PHSecchi/robo_sumo/Esquema Elétrico/ROBO SUMO R1 - 3D Visualization.pdf

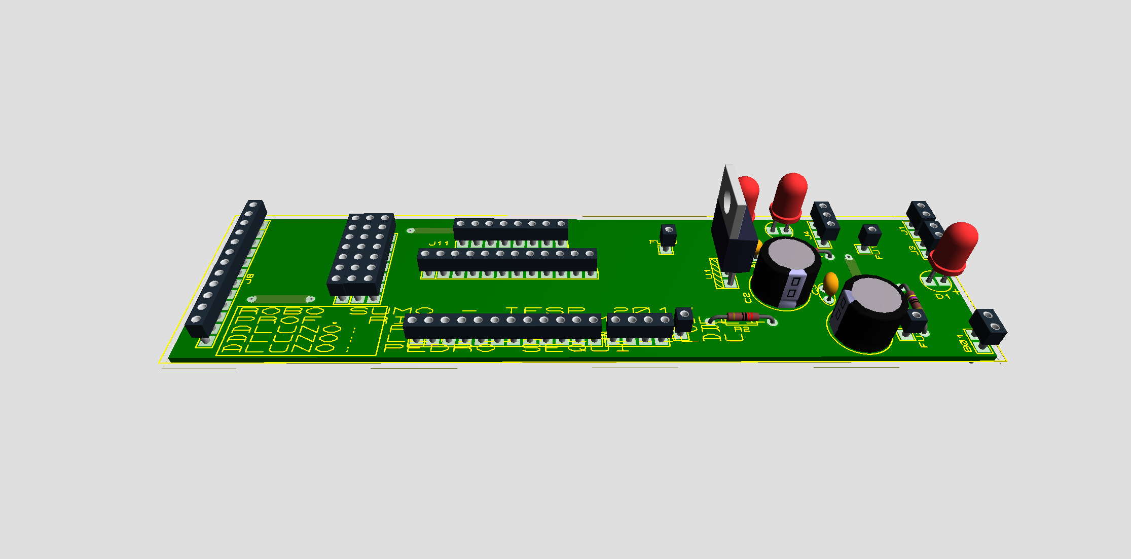
[picture p1: figure]
