PHSecchi/robo_sumo/Desenhos 3D/CONJ. CUBO RODA.pdf

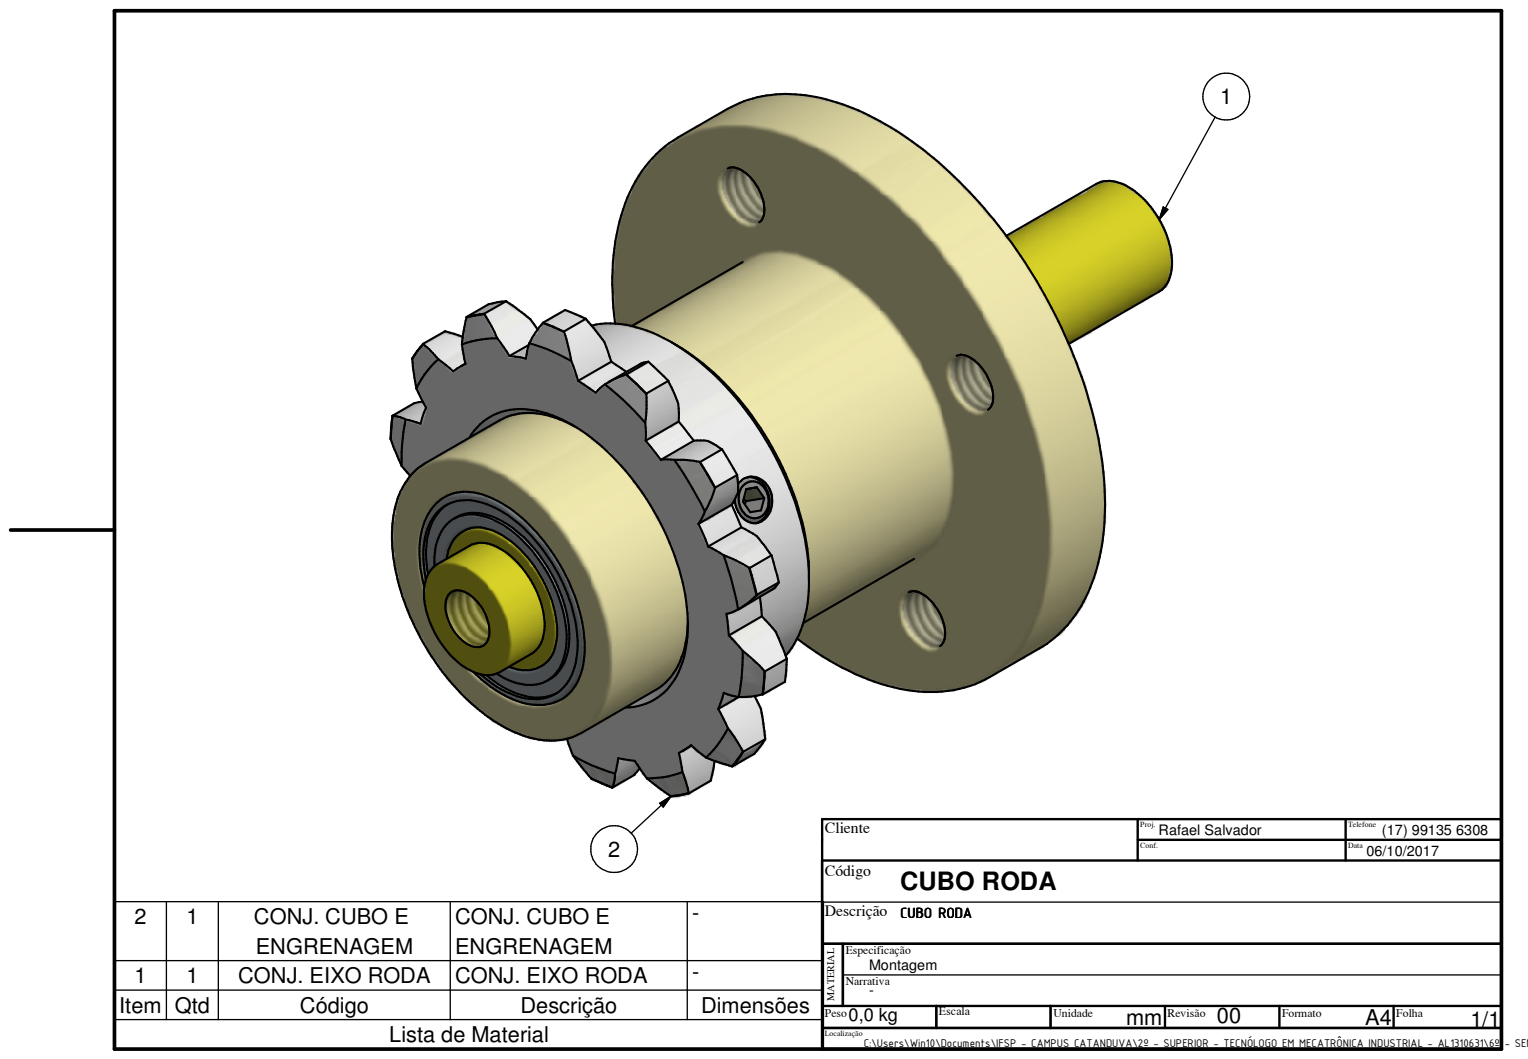
[picture p2: page 1]
Unidade; Código; Narrativa; CUBO RODA; Montagem - Localização; C:\Users\Win10\Documents\IFSP - CAMPUS CATANDUVA\2º - SUPERIOR - TECNÓLOGO EM MECATRÔNICA INDUSTRIAL - AL1310631\6º; - SEM; Peso0,0 kg; Formato; Folha; 1/1 Escala; Revisão 00; CONJ. EIXO RODA; - Lista de Material Item; Qtd; Descrição; Dimensões

Cliente | Proj. Rafael Salvador | Telefone (17) 99135 6308

Conf. | Data 06/10/2017

1 | CONJ. CUBO E | - ENGRENAGEM CONJ. CUBO E ENGRENAGEM 2 | Descrição CUBORODA

Especificação
