PHSecchi/robo_sumo/Desenhos 3D/CONJ. LATERAL ESQUERDO.pdf

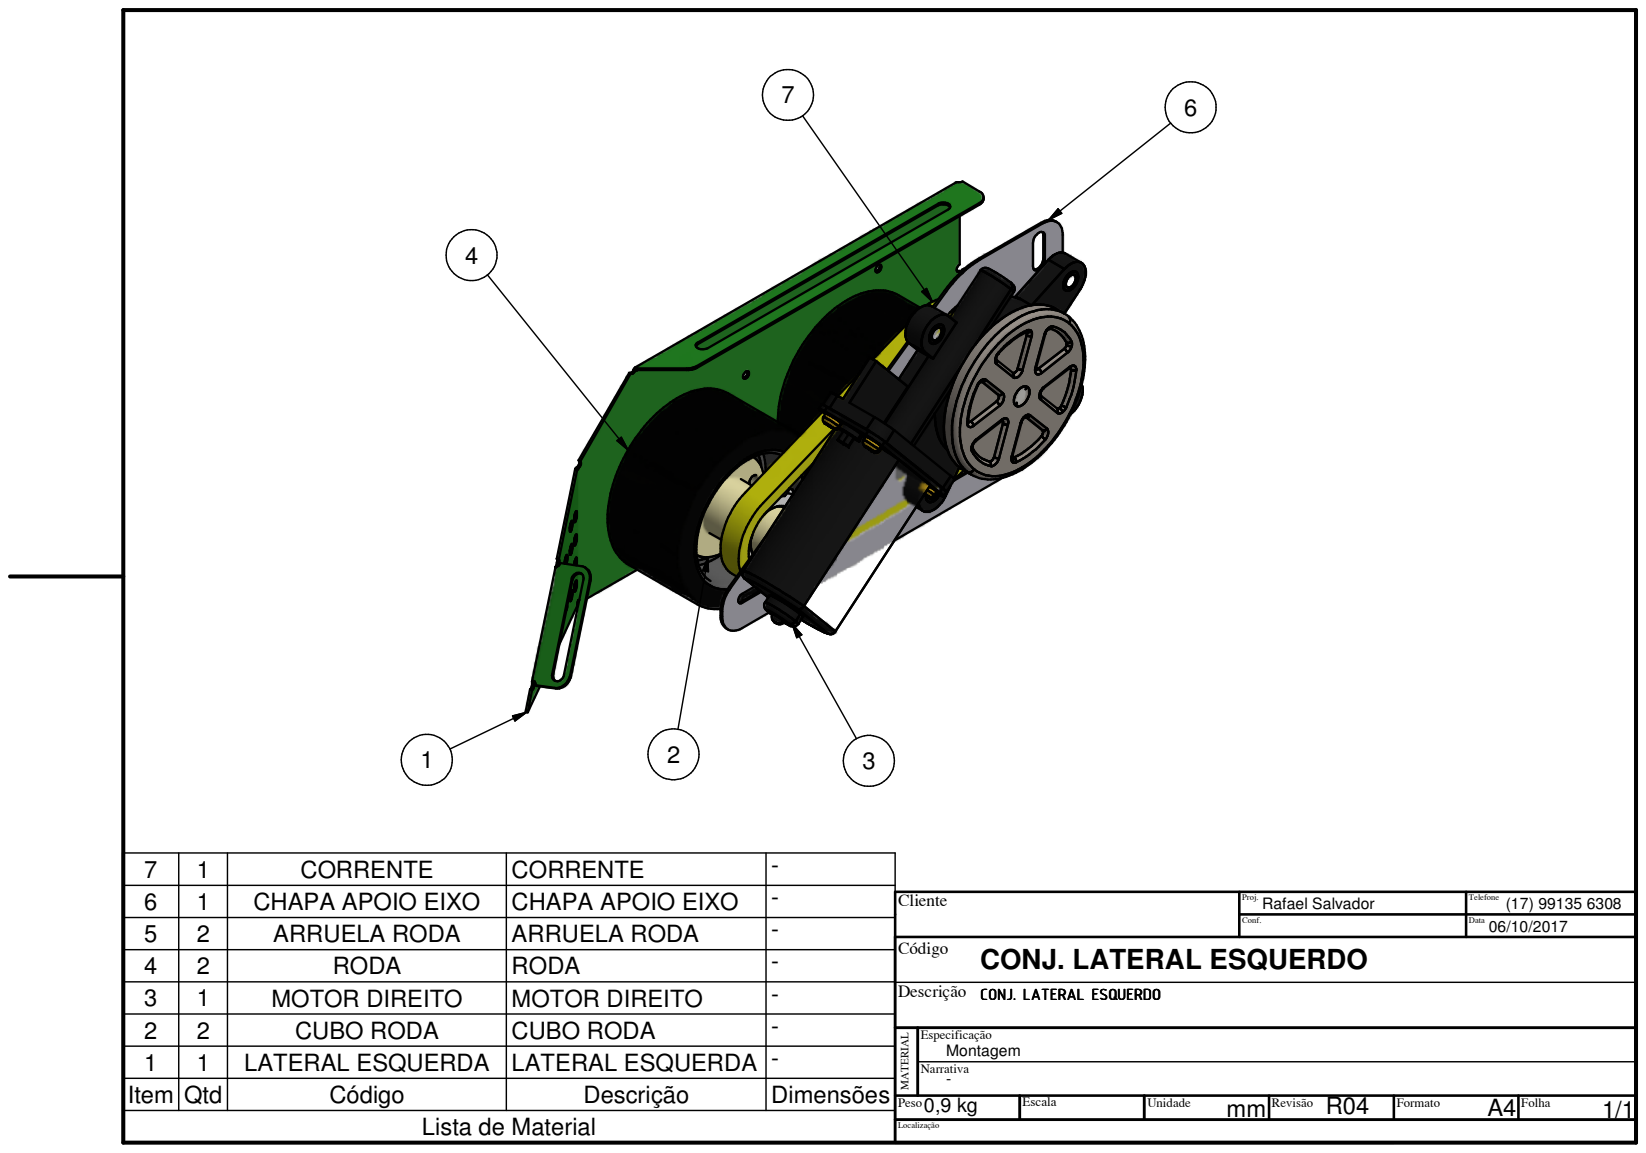
[picture p3: page 1]
Unidade; Código; Narrativa; Montagem - Localização; Peso0,9 kg; Formato; Folha; 1/1 Escala; Revisão R04; CORRENTE; CHAPA APOIO EIXO; ARRUELA RODA; RODA; MOTOR DIREITO; CUBO RODA; LATERAL ESQUERDA; - Lista de Material Item; Qtd; Descrição; Dimensões

Cliente | Proj. Rafael Salvador | Telefone (17) 99135 6308

Conf. | Data 06/10/2017

CONJ. LATERAL ESQUERDO

Descrição CONJ.LATERALESQUERDO

Especificação
