PHSecchi/robo_sumo/Desenhos 3D/ROBO SUMO.pdf

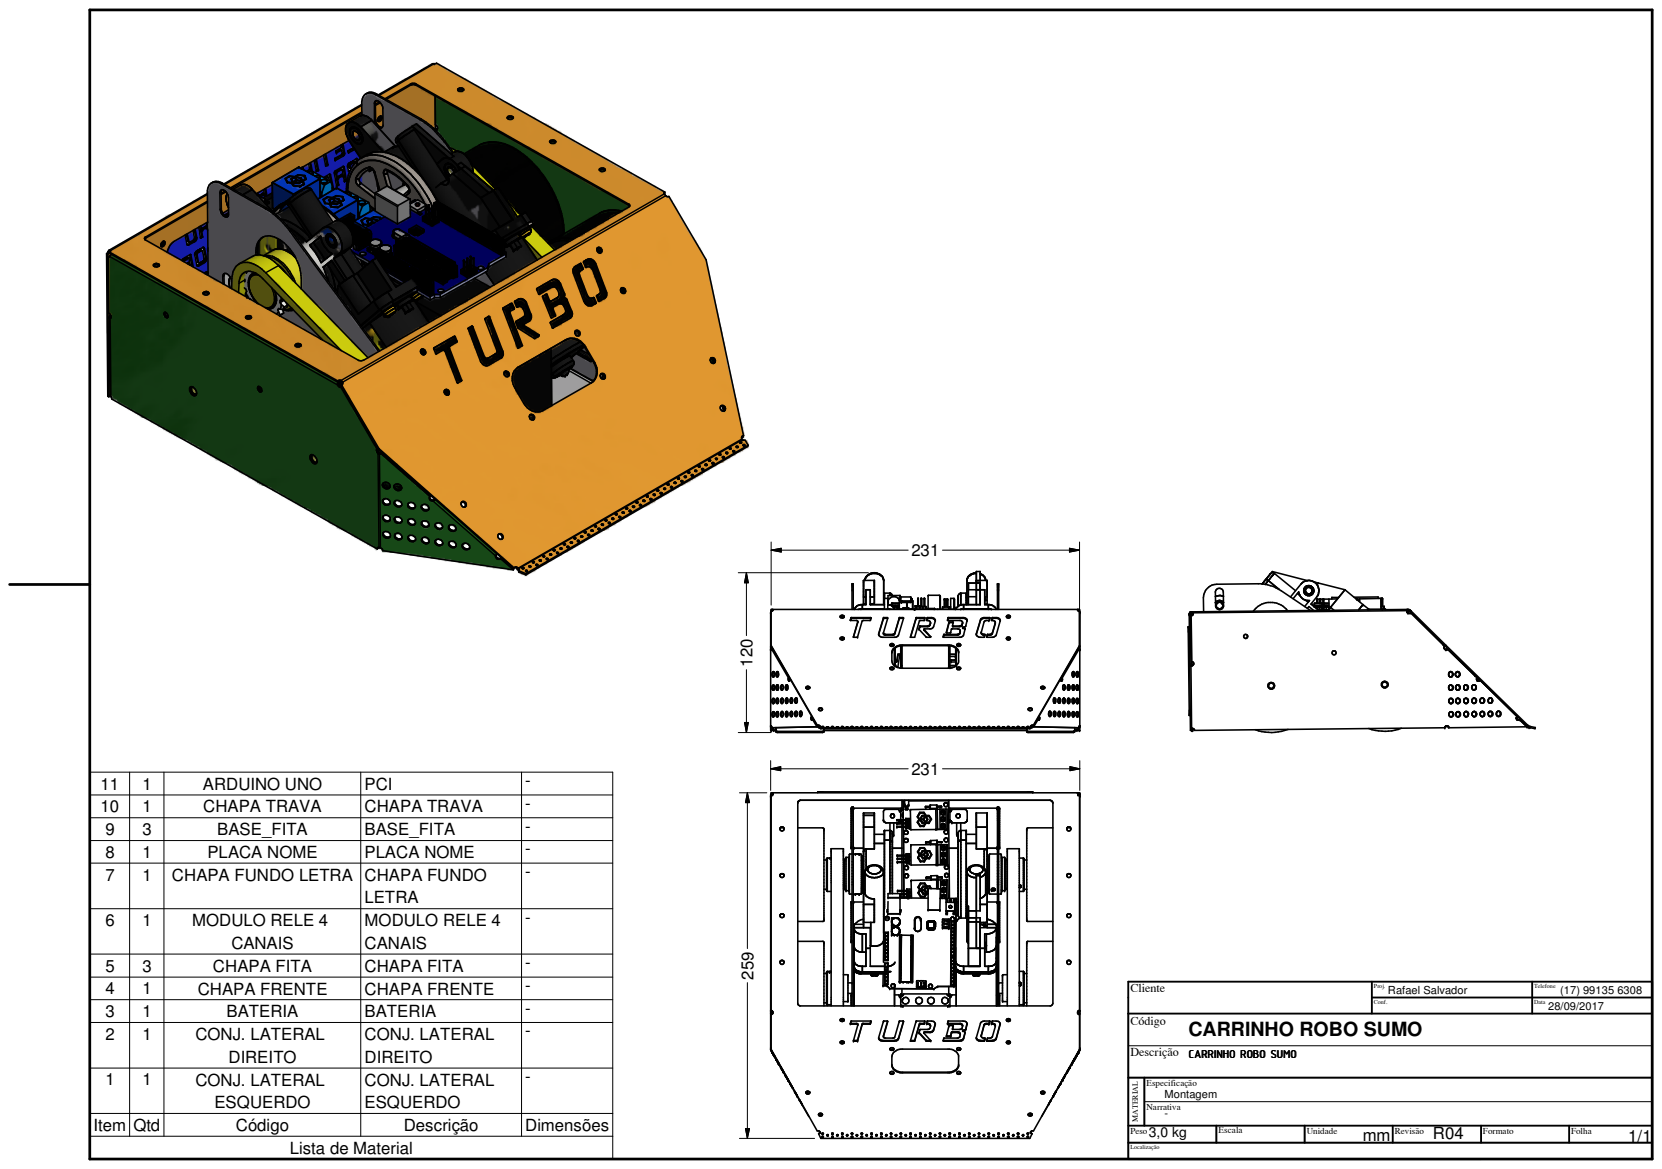
[picture p4: page 1]
Proj.; Conf.; Telefone; Unidade; MATERIAL; Código; Descrição; Especificação; Narrativa; CARRINHOROBOSUMO; Montagem; - Localização; Rafael Salvador; Peso3,0 kg; Formato; Folha; 1/1 Escala; Data 28/09/2017; Revisão R04; Cliente; ARDUINO UNO; PCI; CHAPA TRAVA; BASE_FITA; PLACA NOME; - CHAPA FUNDO; - LETRA; CHAPA FUNDO LETRA; MODULO RELE 4; CHAPA FITA; CHAPA FRENTE; BATERIA; - CONJ. LATERAL; CONJ. LATERAL; Item Qtd; Dimensões

- CANAIS MODULO RELE 4 CANAIS

CARRINHO ROBO SUMO

- DIREITO CONJ. LATERAL DIREITO

- ESQUERDO CONJ. LATERAL ESQUERDO

Lista de Material
