PHSecchi/robo_sumo/Desenhos 3D/CUBO RODA.pdf

n40

5

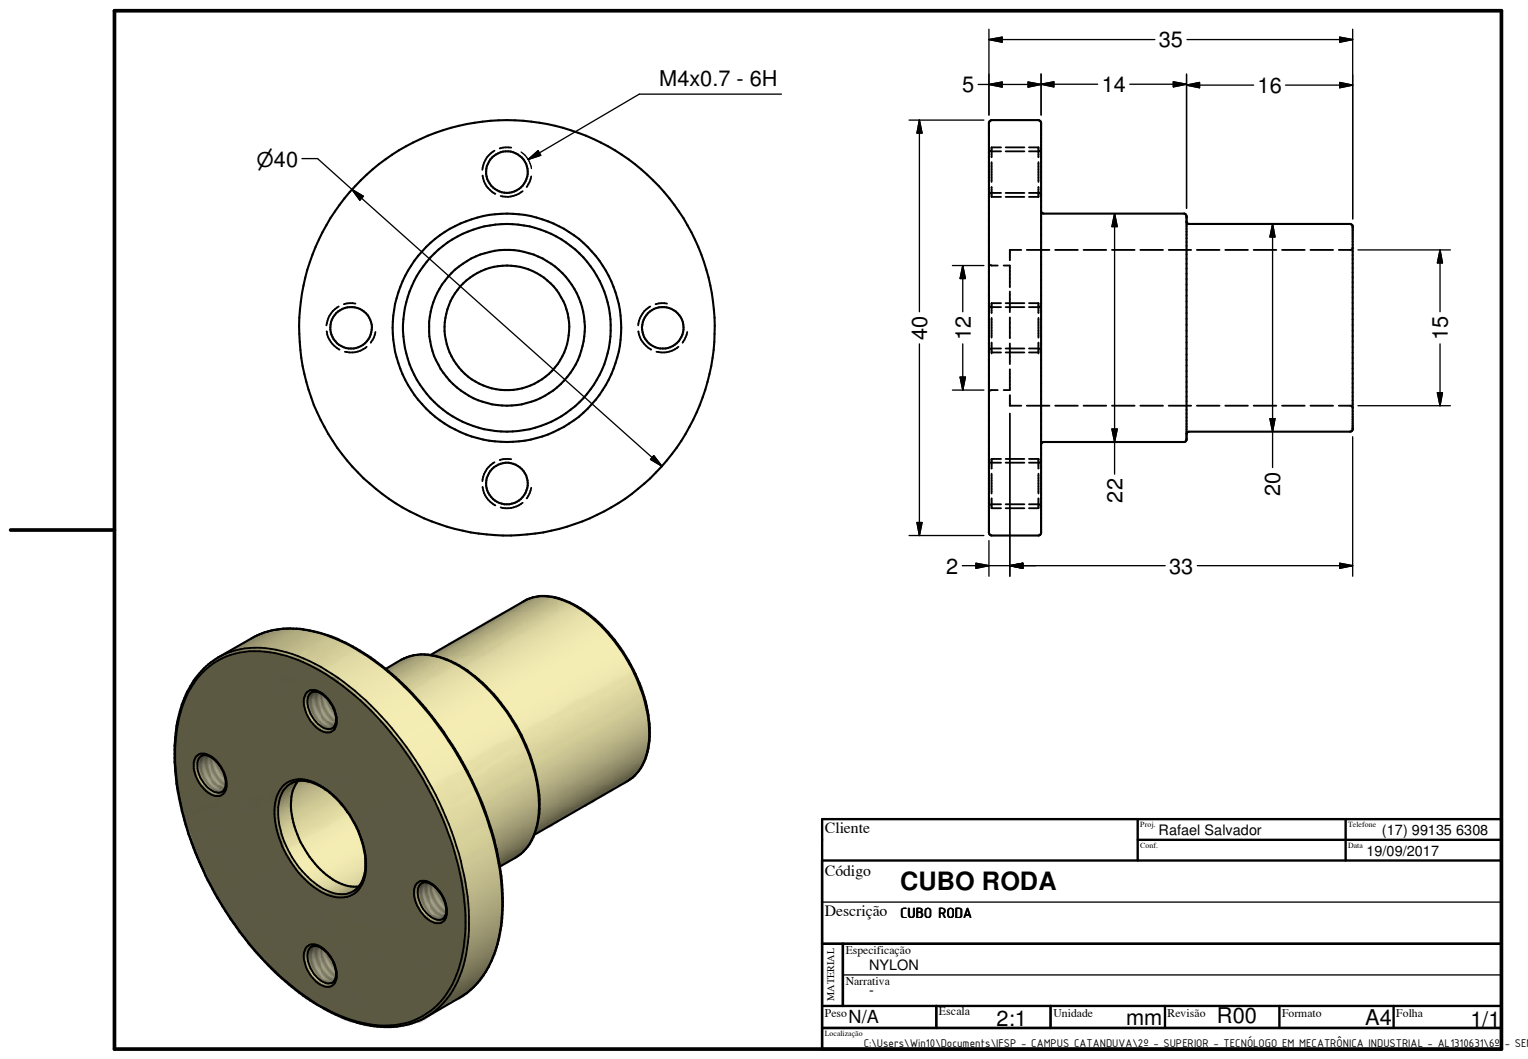
[picture p5: page 1]
Unidade; Código; Descrição; Especificação; Narrativa; CUBO RODA; CUBORODA; NYLON - Localização; C:\Users\Win10\Documents\IFSP - CAMPUS CATANDUVA\2º - SUPERIOR - TECNÓLOGO EM MECATRÔNICA INDUSTRIAL - AL1310631\6º; - SEM; PesoN/A; Formato; Folha; 1/1 Escala; Revisão R00

Cliente | Proj. Rafael Salvador | Telefone (17) 99135 6308

Conf. | Data 19/09/2017
