PHSecchi/robo_sumo/Esquema Elétrico/ROBO SUMO R1 - CIRCUITO ELETRICO.pdf

## FU1A

D3

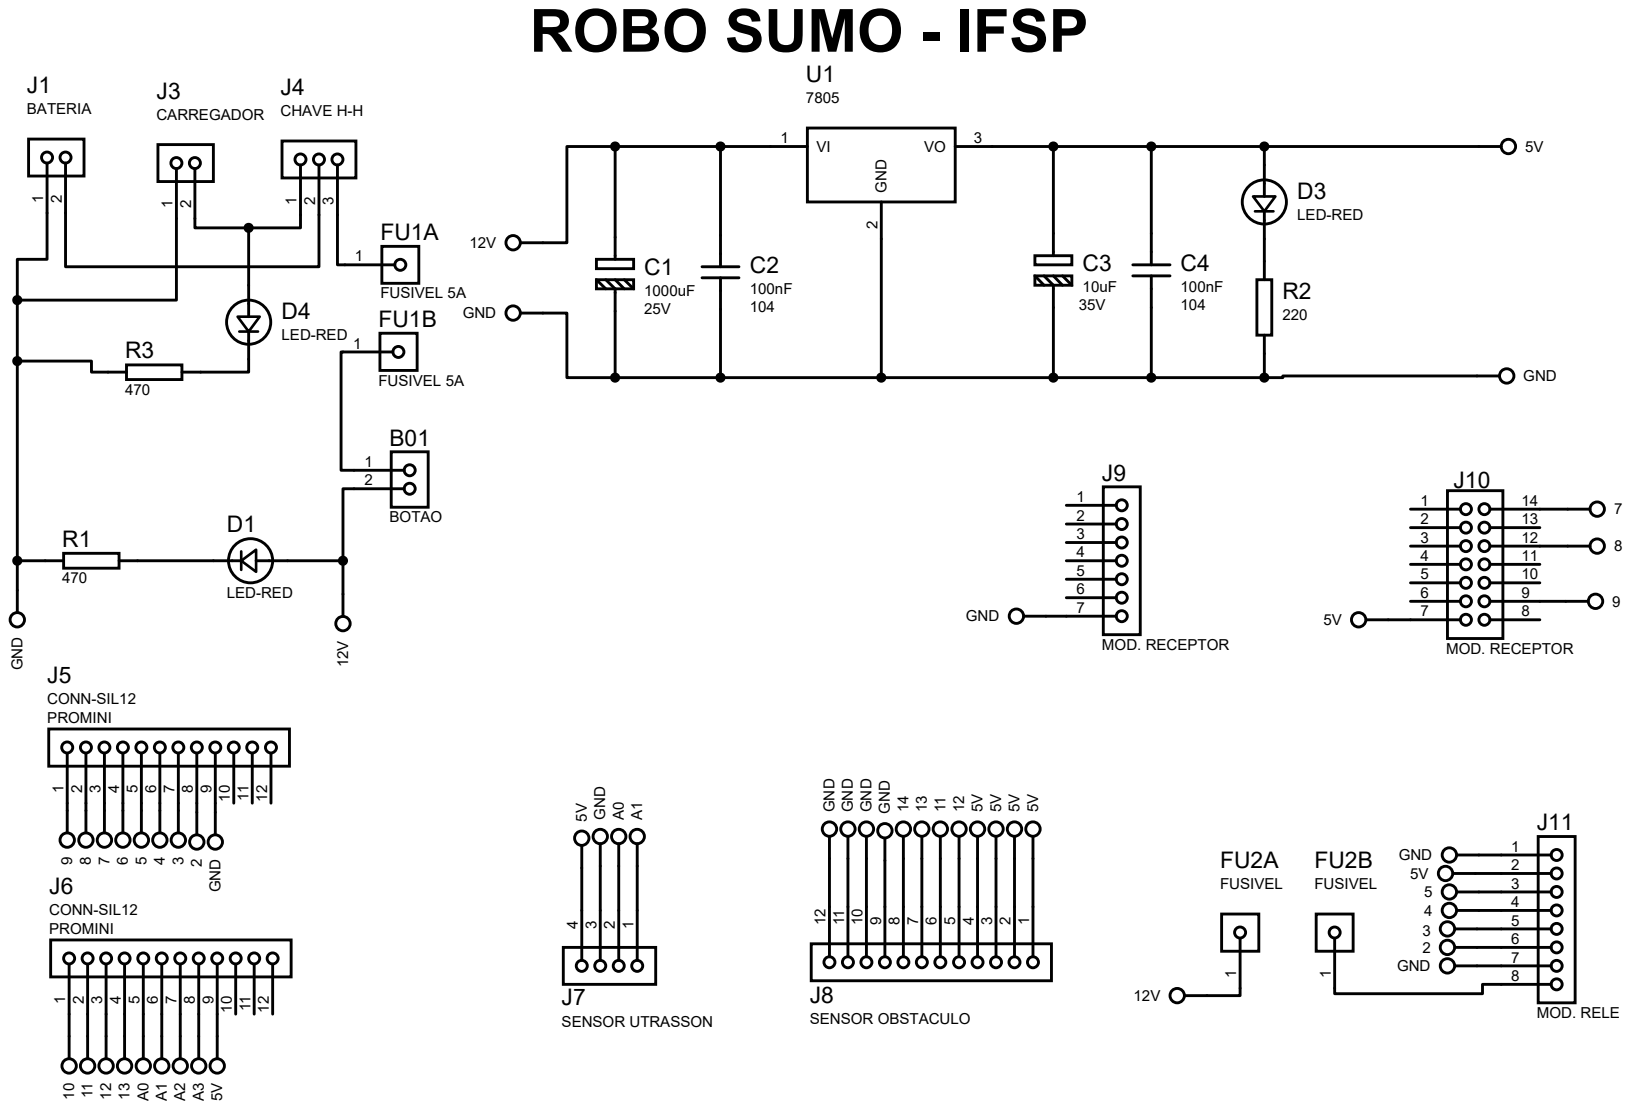
[picture p7: page 1]
