PHSecchi/robo_sumo/Esquema Elétrico/ROBO SUMO R1_LAYOUT BAIXO.pdf

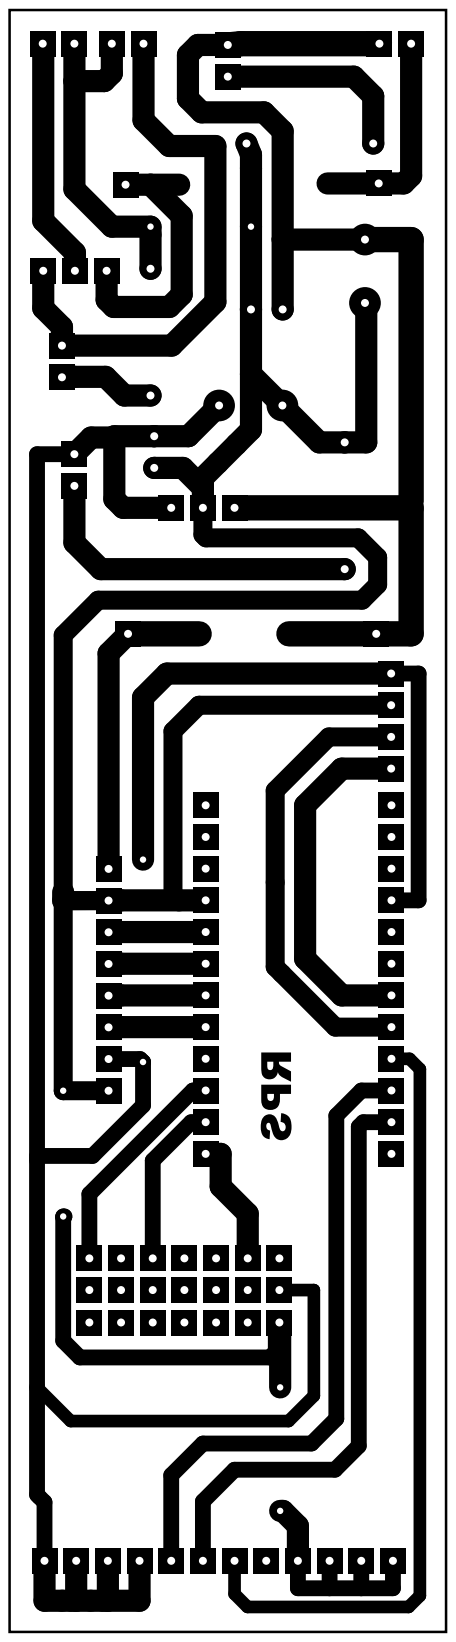
[picture p8: page 1]
