PHSecchi/robo_sumo/Esquema Elétrico/ROBO SUMO R1_LAYOUT CIMA.pdf

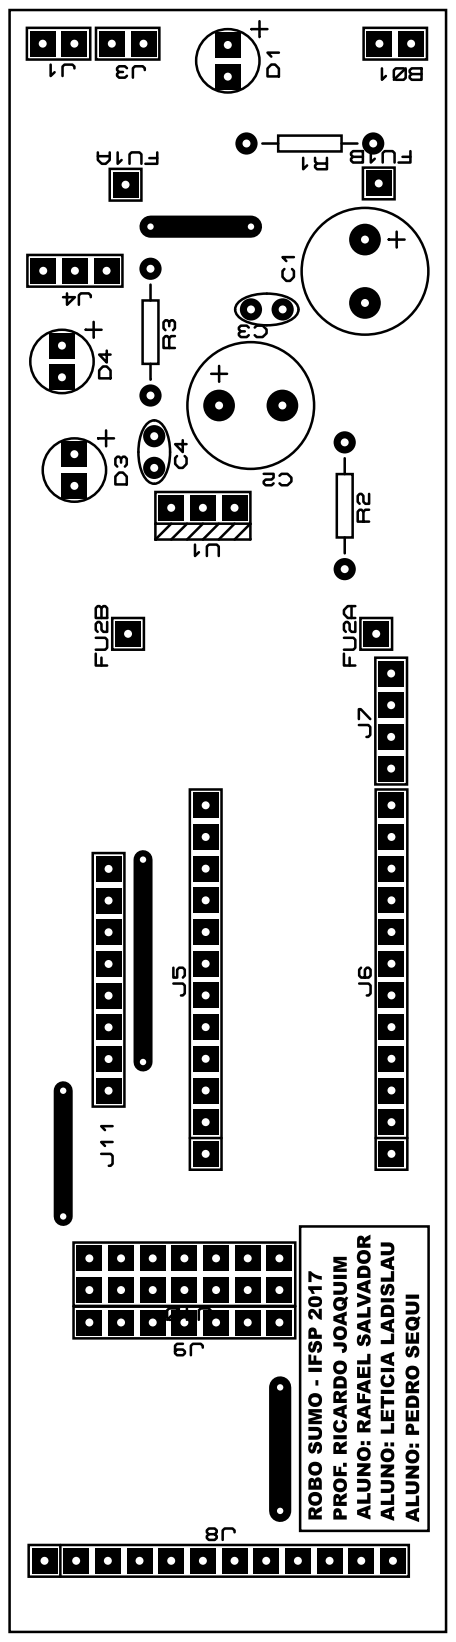
[picture p9: page 1]
